pradeepsk13/vsdsram_sky130_1.8V/others/holdsnm1.jpg

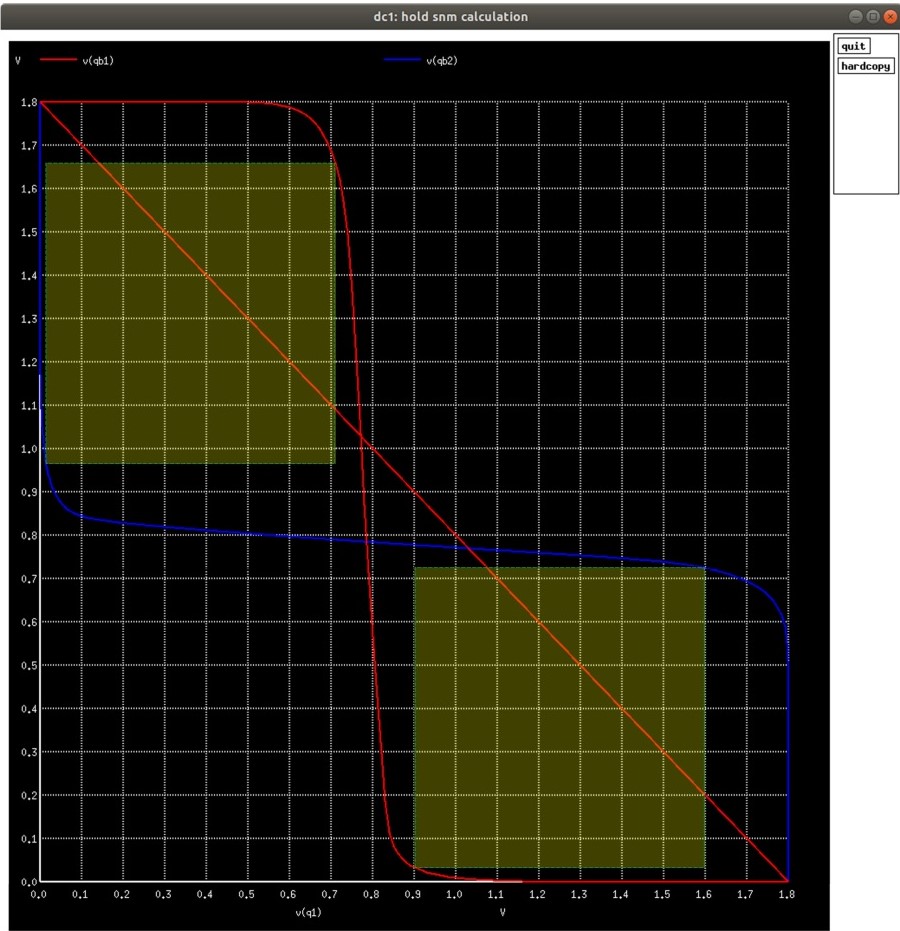
others/holdsnm1.jpg
