pradeepsk13/vsdsram_sky130_1.8V/others/layout_snaps/precharge_circuit.png

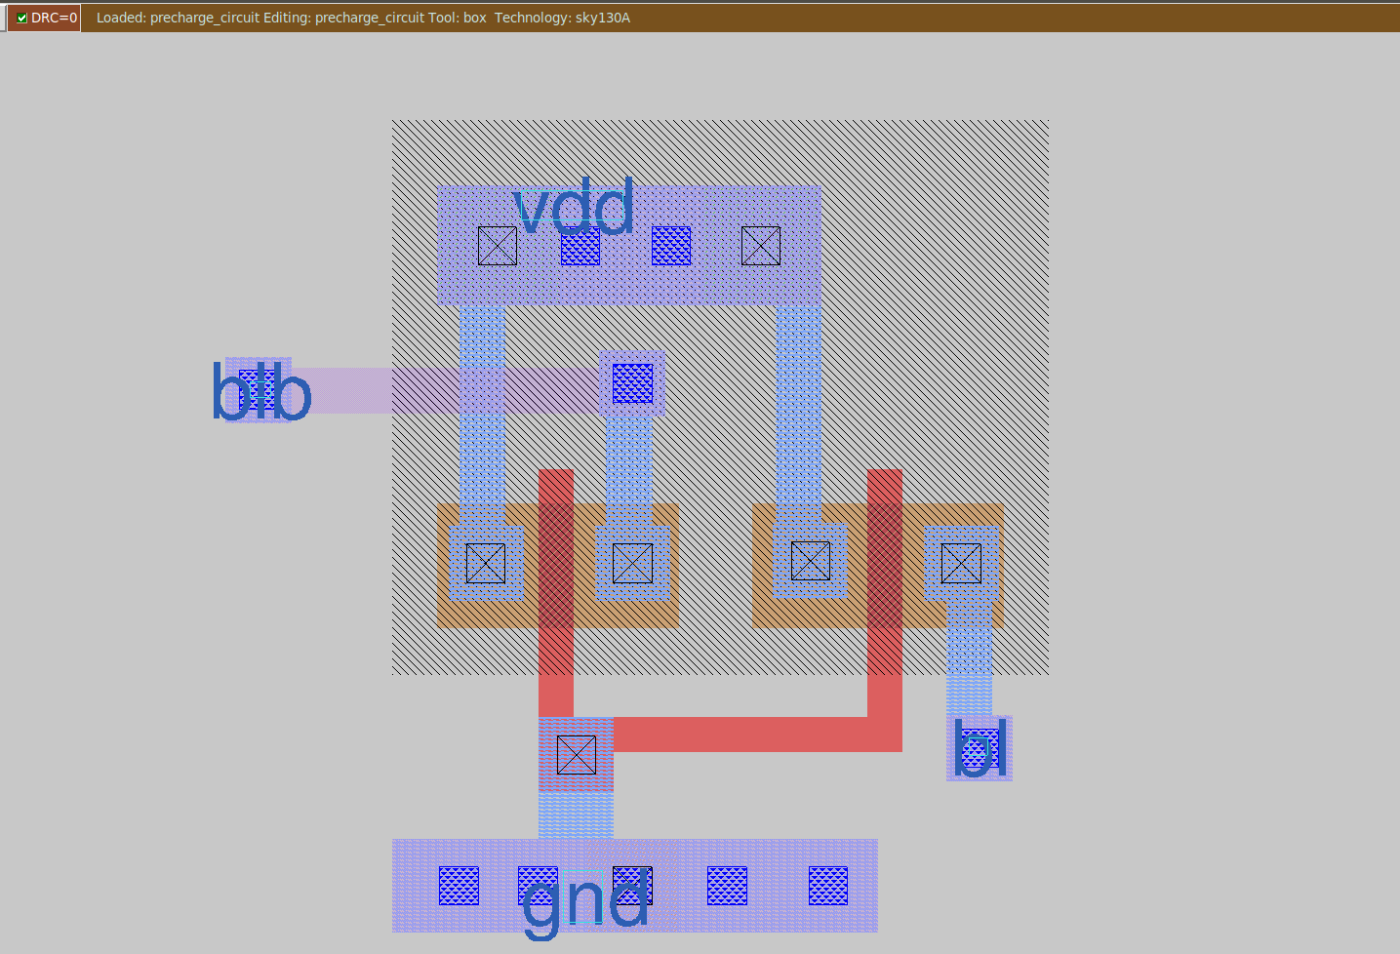
others/layout_snaps/precharge_circuit.png
