pradeepsk13/vsdsram_sky130_1.8V/others/readsnm1.png

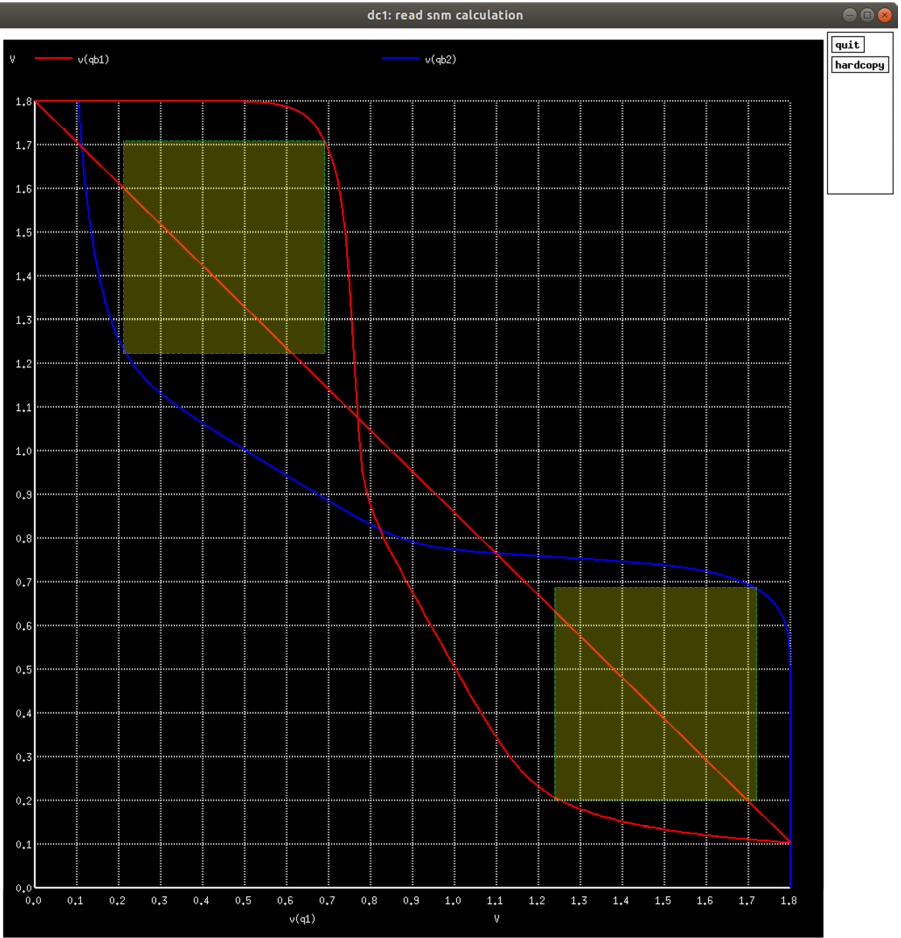
others/readsnm1.png
