pradeepsk13/vsdsram_sky130_1.8V/others/writesnm1.png

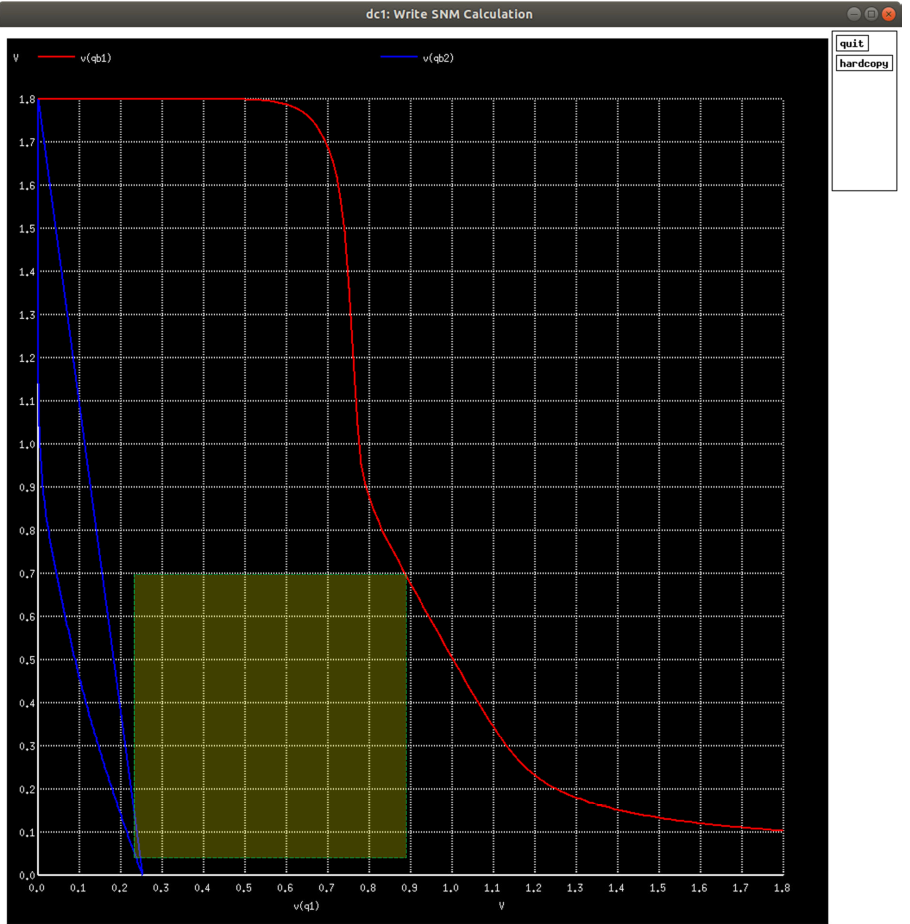
others/writesnm1.png
