pradeepsk13/vsdsram_sky130_1.8V/waveforms/prelayout/ncurve_read.png

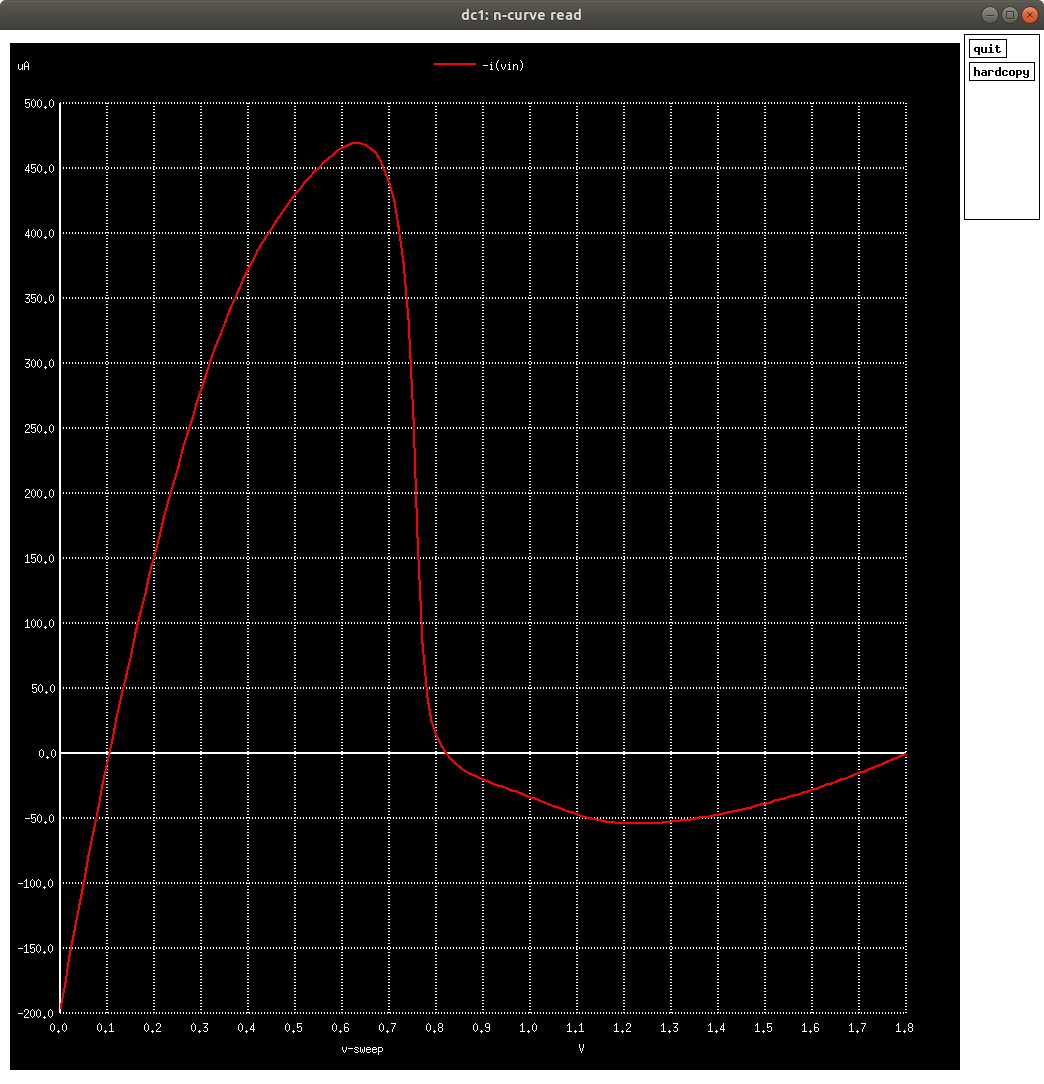
waveforms/prelayout/ncurve_read.png
