pradeepsk13/vsdsram_sky130_1.8V/Openram/Openram_Results/31_03_21_VSDSRAM_2x16/sram_2_16_sky130A.html

VLSIDA

(https://vlsida.soe.ucsc.edu/) (https://github.com/VLSIDA/OpenRAM)

OpenRAM

sram_2_16_sky130A.html

Compiled at: 2021-03-30

DRC errors: skipped

LVS errors: skipped

Git commit id: 608e4b81f1763727e7efe087d591c76956869fe6

Ports and Configuration

Type | Value
WORD_SIZE | 2
NUM_WORDS | 16
NUM_BANKS | 1
NUM_RW_PORTS | 1
NUM_R_PORTS | 0
NUM_W_PORTS | 0
Area (µm²) | 7121

Operating Conditions

Parameter | Min | Typ | Max | Units
Power supply (VDD) range | 1.8 | 1.8 | 1.8 | Volts
Operating Temperature | 0 | 25 | 100 | Celsius
Operating Frequency (F) | | | 174 | MHz

Timing Data

Using analytical model: results may not be precise

Parameter | Min | Max | Units
din0[1:0] setup rising | 0.009 | 0.009 | ns
din0[1:0] setup falling | 0.009 | 0.009 | ns
din0[1:0] hold rising | 0.001 | 0.001 | ns
din0[1:0] hold falling | 0.001 | 0.001 | ns
dout0[1:0] cell rise | -0.975 | 1.702 | ns
dout0[1:0] cell fall | 1.344 | 1.547 | ns
dout0[1:0] rise transition | 0.007 | 0.027 | ns
dout0[1:0] fall transition | 0.007 | 0.027 | ns
csb0 setup rising | 0.009 | 0.009 | ns
csb0 setup falling | 0.009 | 0.009 | ns
csb0 hold rising | 0.001 | 0.001 | ns
csb0 hold falling | 0.001 | 0.001 | ns
addr0[3:0] setup rising | 0.009 | 0.009 | ns
addr0[3:0] setup falling | 0.009 | 0.009 | ns
addr0[3:0] hold rising | 0.001 | 0.001 | ns
addr0[3:0] hold falling | 0.001 | 0.001 | ns
web0 setup rising | 0.009 | 0.009 | ns
web0 setup falling | 0.009 | 0.009 | ns
web0 hold rising | 0.001 | 0.001 | ns
web0 hold falling | 0.001 | 0.001 | ns

Power Data

Pins | Mode | Power | Units
!csb0 & clk0 & !web0 | Read Rising | 0.4618 | mW
!csb0 & clk0 & !web0 | Read Falling | 0.4618 | mW
!csb0 & !clk0 & web0 | Write Rising | 0.4618 | mW
!csb0 & !clk0 & web0 | Write Falling | 0.4618 | mW
csb0 | leakage | 0.000196 | mW

Characterization Corners

Transistor Type | Power Supply | Temperature | Corner Name
TT | 1.8 | 25 | _TT_1p8V_25C.lib
SS | 1.8 | 25 | _SS_1p8V_25C.lib
FF | 1.8 | 25 | _FF_1p8V_25C.lib
TT | 1.8 | 100 | _TT_1p8V_100C.lib
TT | 1.8 | 0 | _TT_1p8V_0C.lib

Deliverables

Type | Description | Link
.gds | GDSII layout views | sram_2_16_sky130A.gds
.html | This datasheet | sram_2_16_sky130A.html
.lef | LEF files | sram_2_16_sky130A.lef
.lib | Synthesis models | sram_2_16_sky130A_TT_1p8V_25C.lib
.lib | Synthesis models | sram_2_16_sky130A_SS_1p8V_25C.lib
.lib | Synthesis models | sram_2_16_sky130A_FF_1p8V_25C.lib
.lib | Synthesis models | sram_2_16_sky130A_TT_1p8V_100C.lib
.lib | Synthesis models | sram_2_16_sky130A_TT_1p8V_0C.lib
.log | OpenRAM compile log | sram_2_16_sky130A.log
.py | OpenRAM configuration file | sram_2_16_sky130A.py
.sp | SPICE netlists | sram_2_16_sky130A.sp
.v | Verilog simulation models | sram_2_16_sky130A.v
