pradeepsk13/vsdsram_sky130_1.8V/Openram/Openram_Results/31_03_21_VSDSRAM_2x16/functional_stim.sp

* Functional test stimulus file for 20ns period

* TT process corner
.include "/home/peepu/VSDSRAM_sky130/OpenRAM/technology/sky130A/models/corners/tt.sp"
.include "sram_2_16_sky130A.sp"

* Global Power Supplies
Vvdd vdd 0 1.8

*Nodes gnd and 0 are the same global ground node in ngspice/hspice/xa. Otherwise, this source may be needed.
*Vgnd gnd 0 0.0

* Instantiation of the SRAM
Xsram_2_16_sky130A din0_0 din0_1 a0_0 a0_1 a0_2 a0_3 CSB0 WEB0 clk0 dout0_0 dout0_1 vdd gnd sram_2_16_sky130A

* SRAM output loads
CD00 dout0_0  0 39.2968f
CD01 dout0_1  0 39.2968f


* Important signals for debug
* bl: xsram_2_16_sky130a.xbank0.bl_0_0
* br: xsram_2_16_sky130a.xbank0.br_0_0
* s_en: xsram_2_16_sky130a.s_en
* q: xsram_2_16_sky130A.xbank0.xbitcell_array.xbitcell_array.xbit_r0_c0.Q
* qbar: xsram_2_16_sky130A.xbank0.xbitcell_array.xbitcell_array.xbit_r0_c0.Q_bar


* Sequence of operations
*	Idle during cycle 0 (0ns - 20ns)
*	Writing 11  to  address 0001 (from port 0) during cycle 1 (20ns - 40ns)
*	Reading 11 from address 0001 (from port 0) during cycle 4 (80ns - 100ns)
*	Writing 10  to  address 0100 (from port 0) during cycle 5 (100ns - 120ns)
*	Writing 01  to  address 1001 (from port 0) during cycle 6 (120ns - 140ns)
*	Reading 11 from address 0001 (from port 0) during cycle 8 (160ns - 180ns)
*	Writing 01  to  address 0101 (from port 0) during cycle 9 (180ns - 200ns)
*	Reading 01 from address 1001 (from port 0) during cycle 11 (220ns - 240ns)
*	Reading 10 from address 0100 (from port 0) during cycle 12 (240ns - 260ns)
*	Writing 10  to  address 1001 (from port 0) during cycle 16 (320ns - 340ns)
*	Writing 11  to  address 0011 (from port 0) during cycle 17 (340ns - 360ns)
*	Reading 11 from address 0011 (from port 0) during cycle 19 (380ns - 400ns)
*	Writing 11  to  address 1010 (from port 0) during cycle 20 (400ns - 420ns)
*	Writing 01  to  address 1001 (from port 0) during cycle 21 (420ns - 440ns)
*	Writing 10  to  address 1010 (from port 0) during cycle 23 (460ns - 480ns)
*	Writing 01  to  address 0000 (from port 0) during cycle 24 (480ns - 500ns)
*	Writing 01  to  address 0110 (from port 0) during cycle 25 (500ns - 520ns)
*	Writing 10  to  address 1100 (from port 0) during cycle 26 (520ns - 540ns)
*	Reading 01 from address 0101 (from port 0) during cycle 27 (540ns - 560ns)
*	Writing 10  to  address 1011 (from port 0) during cycle 30 (600ns - 620ns)
*	Writing 00  to  address 1011 (from port 0) during cycle 33 (660ns - 680ns)
*	Reading 11 from address 0001 (from port 0) during cycle 34 (680ns - 700ns)
*	Reading 10 from address 1100 (from port 0) during cycle 35 (700ns - 720ns)
*	Reading 10 from address 0100 (from port 0) during cycle 37 (740ns - 760ns)
*	Writing 10  to  address 1111 (from port 0) during cycle 38 (760ns - 780ns)
*	Writing 10  to  address 1000 (from port 0) during cycle 40 (800ns - 820ns)
*	Writing 11  to  address 1100 (from port 0) during cycle 41 (820ns - 840ns)
*	Writing 01  to  address 0111 (from port 0) during cycle 42 (840ns - 860ns)
*	Reading 01 from address 1001 (from port 0) during cycle 43 (860ns - 880ns)
*	Reading 10 from address 1010 (from port 0) during cycle 44 (880ns - 900ns)
*	Writing 01  to  address 1100 (from port 0) during cycle 49 (980ns - 1000ns)
*	Reading 01 from address 0111 (from port 0) during cycle 50 (1000ns - 1020ns)
*	Writing 01  to  address 1110 (from port 0) during cycle 51 (1020ns - 1040ns)
*	Reading 01 from address 0000 (from port 0) during cycle 53 (1060ns - 1080ns)
*	Writing 11  to  address 1100 (from port 0) during cycle 54 (1080ns - 1100ns)
*	Reading 01 from address 1110 (from port 0) during cycle 55 (1100ns - 1120ns)
*	Reading 11 from address 0001 (from port 0) during cycle 56 (1120ns - 1140ns)
*	Writing 10  to  address 1101 (from port 0) during cycle 59 (1180ns - 1200ns)
*	Reading 01 from address 0111 (from port 0) during cycle 61 (1220ns - 1240ns)
*	Writing 01  to  address 1001 (from port 0) during cycle 63 (1260ns - 1280ns)
*	Reading 10 from address 1111 (from port 0) during cycle 64 (1280ns - 1300ns)
*	Writing 01  to  address 0010 (from port 0) during cycle 65 (1300ns - 1320ns)
*	Reading 11 from address 0001 (from port 0) during cycle 66 (1320ns - 1340ns)
*	Writing 10  to  address 1111 (from port 0) during cycle 67 (1340ns - 1360ns)
*	Reading 11 from address 0001 (from port 0) during cycle 69 (1380ns - 1400ns)
*	Reading 11 from address 0011 (from port 0) during cycle 70 (1400ns - 1420ns)
*	Writing 11  to  address 1011 (from port 0) during cycle 71 (1420ns - 1440ns)
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
