pradeepsk13/vsdsram_sky130_1.8V/Openram/Openram_Results/26_03_21_VSDSRAM_32x256/functional_stim.sp

* Functional test stimulus file for 20ns period

* TT process corner
.include "/home/peepu/VSDSRAM_sky130/OpenRAM/technology/sky130A/models/corners/tt.sp"
.include "sram_32_256_sky130A.sp"

* Global Power Supplies
Vvdd vdd 0 1.8

*Nodes gnd and 0 are the same global ground node in ngspice/hspice/xa. Otherwise, this source may be needed.
*Vgnd gnd 0 0.0

* Instantiation of the SRAM
Xsram_32_256_sky130A din0_0 din0_1 din0_2 din0_3 din0_4 din0_5 din0_6 din0_7 din0_8 din0_9 din0_10 din0_11 din0_12 din0_13 din0_14 din0_15 din0_16 din0_17 din0_18 din0_19 din0_20 din0_21 din0_22 din0_23 din0_24 din0_25 din0_26 din0_27 din0_28 din0_29 din0_30 din0_31 a0_0 a0_1 a0_2 a0_3 a0_4 a0_5 a0_6 a0_7 CSB0 WEB0 clk0 dout0_0 dout0_1 dout0_2 dout0_3 dout0_4 dout0_5 dout0_6 dout0_7 dout0_8 dout0_9 dout0_10 dout0_11 dout0_12 dout0_13 dout0_14 dout0_15 dout0_16 dout0_17 dout0_18 dout0_19 dout0_20 dout0_21 dout0_22 dout0_23 dout0_24 dout0_25 dout0_26 dout0_27 dout0_28 dout0_29 dout0_30 dout0_31 vdd gnd sram_32_256_sky130A

* SRAM output loads
CD00 dout0_0  0 39.2968f
CD01 dout0_1  0 39.2968f
CD02 dout0_2  0 39.2968f
CD03 dout0_3  0 39.2968f
CD04 dout0_4  0 39.2968f
CD05 dout0_5  0 39.2968f
CD06 dout0_6  0 39.2968f
CD07 dout0_7  0 39.2968f
CD08 dout0_8  0 39.2968f
CD09 dout0_9  0 39.2968f
CD010 dout0_10  0 39.2968f
CD011 dout0_11  0 39.2968f
CD012 dout0_12  0 39.2968f
CD013 dout0_13  0 39.2968f
CD014 dout0_14  0 39.2968f
CD015 dout0_15  0 39.2968f
CD016 dout0_16  0 39.2968f
CD017 dout0_17  0 39.2968f
CD018 dout0_18  0 39.2968f
CD019 dout0_19  0 39.2968f
CD020 dout0_20  0 39.2968f
CD021 dout0_21  0 39.2968f
CD022 dout0_22  0 39.2968f
CD023 dout0_23  0 39.2968f
CD024 dout0_24  0 39.2968f
CD025 dout0_25  0 39.2968f
CD026 dout0_26  0 39.2968f
CD027 dout0_27  0 39.2968f
CD028 dout0_28  0 39.2968f
CD029 dout0_29  0 39.2968f
CD030 dout0_30  0 39.2968f
CD031 dout0_31  0 39.2968f


* Important signals for debug
* bl: xsram_32_256_sky130a.xbank0.bl_0_0
* br: xsram_32_256_sky130a.xbank0.br_0_0
* s_en: xsram_32_256_sky130a.s_en
* q: xsram_32_256_sky130A.xbank0.xbitcell_array.xbitcell_array.xbit_r0_c0.Q
* qbar: xsram_32_256_sky130A.xbank0.xbitcell_array.xbitcell_array.xbit_r0_c0.Q_bar


* Sequence of operations
*	Idle during cycle 0 (0ns - 20ns)
*	Writing 11110110010100110001001101101100  to  address 01100000 (from port 0) during cycle 1 (20ns - 40ns)
*	Reading 11110110010100110001001101101100 from address 01100000 (from port 0) during cycle 3 (60ns - 80ns)
*	Writing 11111010001010111110010110100101  to  address 01100111 (from port 0) during cycle 5 (100ns - 120ns)
*	Reading 11110110010100110001001101101100 from address 01100000 (from port 0) during cycle 6 (120ns - 140ns)
*	Writing 00000111110101111101101011111010  to  address 11110000 (from port 0) during cycle 8 (160ns - 180ns)
*	Reading 00000111110101111101101011111010 from address 11110000 (from port 0) during cycle 9 (180ns - 200ns)
*	Writing 01100100100101001000010001101101  to  address 00010101 (from port 0) during cycle 10 (200ns - 220ns)
*	Reading 11111010001010111110010110100101 from address 01100111 (from port 0) during cycle 11 (220ns - 240ns)
*	Writing 10101100100001011000111101110000  to  address 11101000 (from port 0) during cycle 13 (260ns - 280ns)
*	Reading 10101100100001011000111101110000 from address 11101000 (from port 0) during cycle 14 (280ns - 300ns)
*	Reading 00000111110101111101101011111010 from address 11110000 (from port 0) during cycle 15 (300ns - 320ns)
*	Reading 10101100100001011000111101110000 from address 11101000 (from port 0) during cycle 16 (320ns - 340ns)
*	Writing 00011111111010100000000100011100  to  address 11110000 (from port 0) during cycle 17 (340ns - 360ns)
*	Writing 01011100001111000011011011100101  to  address 10011101 (from port 0) during cycle 18 (360ns - 380ns)
*	Reading 11111010001010111110010110100101 from address 01100111 (from port 0) during cycle 19 (380ns - 400ns)
*	Reading 01011100001111000011011011100101 from address 10011101 (from port 0) during cycle 20 (400ns - 420ns)
*	Writing 00001000010101111011110000010101  to  address 11110011 (from port 0) during cycle 21 (420ns - 440ns)
*	Writing 10001100010000111101111010001100  to  address 01110110 (from port 0) during cycle 22 (440ns - 460ns)
*	Writing 10100010010110000011011011011110  to  address 01110011 (from port 0) during cycle 23 (460ns - 480ns)
*	Reading 01011100001111000011011011100101 from address 10011101 (from port 0) during cycle 24 (480ns - 500ns)
*	Reading 10100010010110000011011011011110 from address 01110011 (from port 0) during cycle 25 (500ns - 520ns)
*	Writing 11110001000001011000100000101010  to  address 01101100 (from port 0) during cycle 26 (520ns - 540ns)
*	Writing 10001101000001010110111110000001  to  address 00010010 (from port 0) during cycle 30 (600ns - 620ns)
*	Reading 11110110010100110001001101101100 from address 01100000 (from port 0) during cycle 31 (620ns - 640ns)
*	Reading 01100100100101001000010001101101 from address 00010101 (from port 0) during cycle 32 (640ns - 660ns)
*	Reading 10001101000001010110111110000001 from address 00010010 (from port 0) during cycle 36 (720ns - 740ns)
*	Writing 10111010100000000100111100011110  to  address 10001100 (from port 0) during cycle 37 (740ns - 760ns)
*	Writing 10001001000001110001010100011000  to  address 11111110 (from port 0) during cycle 38 (760ns - 780ns)
*	Writing 01001000111100001010010110010101  to  address 11010000 (from port 0) during cycle 39 (780ns - 800ns)
*	Reading 10001101000001010110111110000001 from address 00010010 (from port 0) during cycle 40 (800ns - 820ns)
*	Reading 01100100100101001000010001101101 from address 00010101 (from port 0) during cycle 42 (840ns - 860ns)
*	Reading 10101100100001011000111101110000 from address 11101000 (from port 0) during cycle 43 (860ns - 880ns)
*	Writing 00111111111110010101101001010100  to  address 11110101 (from port 0) during cycle 44 (880ns - 900ns)
*	Writing 10100111100111100011101100000100  to  address 11001100 (from port 0) during cycle 45 (900ns - 920ns)
*	Writing 11011011011010101010100110000000  to  address 11011001 (from port 0) during cycle 46 (920ns - 940ns)
*	Writing 01110010000011001011101001001001  to  address 11010010 (from port 0) during cycle 47 (940ns - 960ns)
*	Writing 11010010110010100110000001111010  to  address 11010111 (from port 0) during cycle 48 (960ns - 980ns)
*	Writing 00111010001001101010101011000110  to  address 00001111 (from port 0) during cycle 49 (980ns - 1000ns)
*	Reading 01100100100101001000010001101101 from address 00010101 (from port 0) during cycle 50 (1000ns - 1020ns)
*	Writing 11101001011111110101001110010000  to  address 11000000 (from port 0) during cycle 51 (1020ns - 1040ns)
*	Writing 00001100000100011101100001111010  to  address 10010011 (from port 0) during cycle 52 (1040ns - 1060ns)
*	Reading 10001100010000111101111010001100 from address 01110110 (from port 0) during cycle 55 (1100ns - 1120ns)
*	Writing 00000111111111110010000100101001  to  address 01001001 (from port 0) during cycle 56 (1120ns - 1140ns)
*	Writing 01000001100010111101000010000010  to  address 00001011 (from port 0) during cycle 58 (1160ns - 1180ns)
*	Writing 01001111001110110010111111011011  to  address 10010010 (from port 0) during cycle 59 (1180ns - 1200ns)
*	Reading 10100111100111100011101100000100 from address 11001100 (from port 0) during cycle 61 (1220ns - 1240ns)
*	Reading 10100010010110000011011011011110 from address 01110011 (from port 0) during cycle 62 (1240ns - 1260ns)
*	Reading 11101001011111110101001110010000 from address 11000000 (from port 0) during cycle 64 (1280ns - 1300ns)
*	Writing 01100110011000101001000011011011  to  address 11011110 (from port 0) during cycle 67 (1340ns - 1360ns)
*	Writing 01100110111010101111110000000100  to  address 01011101 (from port 0) during cycle 68 (1360ns - 1380ns)
*	Reading 01001111001110110010111111011011 from address 10010010 (from port 0) during cycle 70 (1400ns - 1420ns)
*	Writing 11001001110111101001111110011101  to  address 11000000 (from port 0) during cycle 74 (1480ns - 1500ns)
*	Reading 11010010110010100110000001111010 from address 11010111 (from port 0) during cycle 75 (1500ns - 1520ns)
*	Reading 00111111111110010101101001010100 from address 11110101 (from port 0) during cycle 76 (1520ns - 1540ns)
*	Writing 11101010110010100101001010000000  to  address 01000011 (from port 0) during cycle 77 (1540ns - 1560ns)
*	Writing 00100000000101101010000110110010  to  address 00011000 (from port 0) during cycle 79 (1580ns - 1600ns)
*	Reading 11011011011010101010100110000000 from address 11011001 (from port 0) during cycle 82 (1640ns - 1660ns)
*	Writing 00111001010110010010010011111011  to  address 00011111 (from port 0) during cycle 83 (1660ns - 1680ns)
*	Writing 00001010110100011001111010010001  to  address 01010111 (from port 0) during cycle 85 (1700ns - 1720ns)
*	Writing 10010001010010001011110000001011  to  address 00000101 (from port 0) during cycle 86 (1720ns - 1740ns)
*	Writing 10000110010010101100000110100100  to  address 00111110 (from port 0) during cycle 87 (1740ns - 1760ns)
*	Writing 01111101011010010000001011111101  to  address 10000010 (from port 0) during cycle 88 (1760ns - 1780ns)
*	Reading 00100000000101101010000110110010 from address 00011000 (from port 0) during cycle 90 (1800ns - 1820ns)
*	Writing 11100111110100100011010001011110  to  address 01000000 (from port 0) during cycle 91 (1820ns - 1840ns)
*	Reading 00001100000100011101100001111010 from address 10010011 (from port 0) during cycle 94 (1880ns - 1900ns)
*	Writing 10110011101111110111111101010001  to  address 01110101 (from port 0) during cycle 95 (1900ns - 1920ns)
*	Reading 00111010001001101010101011000110 from address 00001111 (from port 0) during cycle 96 (1920ns - 1940ns)
*	Writing 10100101110011011101000011101010  to  address 10101010 (from port 0) during cycle 97 (1940ns - 1960ns)
*	Writing 10111000111110111001101010111101  to  address 01010100 (from port 0) during cycle 99 (1980ns - 2000ns)
*	Writing 01100110001010111110001011010110  to  address 01010000 (from port 0) during cycle 100 (2000ns - 2020ns)
*	Reading 10100010010110000011011011011110 from address 01110011 (from port 0) during cycle 101 (2020ns - 2040ns)
*	Reading 10001101000001010110111110000001 from address 00010010 (from port 0) during cycle 102 (2040ns - 2060ns)
*	Writing 11101011111100001001011101000111  to  address 11101000 (from port 0) during cycle 103 (2060ns - 2080ns)
*	Reading 10000110010010101100000110100100 from address 00111110 (from port 0) during cycle 104 (2080ns - 2100ns)
*	Writing 10111100000100000011001011110110  to  address 00101110 (from port 0) during cycle 105 (2100ns - 2120ns)
*	Reading 01110010000011001011101001001001 from address 11010010 (from port 0) during cycle 106 (2120ns - 2140ns)
*	Writing 10101110100011110111111001001110  to  address 01001000 (from port 0) during cycle 107 (2140ns - 2160ns)
*	Writing 00000011000010110010011110010101  to  address 00110010 (from port 0) during cycle 108 (2160ns - 2180ns)
*	Writing 10011001100001111011000101111110  to  address 11100100 (from port 0) during cycle 109 (2180ns - 2200ns)
*	Writing 11100010000000010010001101011000  to  address 10001001 (from port 0) during cycle 110 (2200ns - 2220ns)
*	Reading 01001000111100001010010110010101 from address 11010000 (from port 0) during cycle 111 (2220ns - 2240ns)
*	Reading 10100111100111100011101100000100 from address 11001100 (from port 0) during cycle 112 (2240ns - 2260ns)
*	Reading 10111000111110111001101010111101 from address 01010100 (from port 0) during cycle 113 (2260ns - 2280ns)
*	Reading 10011001100001111011000101111110 from address 11100100 (from port 0) during cycle 115 (2300ns - 2320ns)
*	Reading 10000110010010101100000110100100 from address 00111110 (from port 0) during cycle 116 (2320ns - 2340ns)
*	Reading 01000001100010111101000010000010 from address 00001011 (from port 0) during cycle 117 (2340ns - 2360ns)
*	Reading 10001100010000111101111010001100 from address 01110110 (from port 0) during cycle 118 (2360ns - 2380ns)
*	Writing 01011101110111011011010011100000  to  address 11111111 (from port 0) during cycle 119 (2380ns - 2400ns)
*	Reading 00001100000100011101100001111010 from address 10010011 (from port 0) during cycle 120 (2400ns - 2420ns)
*	Writing 10010000000100000100101101001001  to  address 01010110 (from port 0) during cycle 122 (2440ns - 2460ns)
*	Writing 01010010111100111101101000001110  to  address 10111111 (from port 0) during cycle 123 (2460ns - 2480ns)
*	Reading 01100110011000101001000011011011 from address 11011110 (from port 0) during cycle 124 (2480ns - 2500ns)
*	Writing 00011011001111000101101010001100  to  address 00010000 (from port 0) during cycle 125 (2500ns - 2520ns)
*	Writing 11001001101100101001110001101011  to  address 10000100 (from port 0) during cycle 126 (2520ns - 2540ns)
*	Writing 10100001110001010011000011011100  to  address 01110011 (from port 0) during cycle 127 (2540ns - 2560ns)
*	Reading 11001001110111101001111110011101 from address 11000000 (from port 0) during cycle 128 (2560ns - 2580ns)
*	Reading 01011100001111000011011011100101 from address 10011101 (from port 0) during cycle 129 (2580ns - 2600ns)
*	Writing 10110001001111111000111001000000  to  address 00011111 (from port 0) during cycle 130 (2600ns - 2620ns)
*	Writing 11001101110000001010110111001101  to  address 10011101 (from port 0) during cycle 131 (2620ns - 2640ns)
*	Reading 10010001010010001011110000001011 from address 00000101 (from port 0) during cycle 132 (2640ns - 2660ns)
*	Writing 00110011110010101001010000010100  to  address 00101101 (from port 0) during cycle 135 (2700ns - 2720ns)
*	Reading 11101010110010100101001010000000 from address 01000011 (from port 0) during cycle 136 (2720ns - 2740ns)
*	Reading 10110011101111110111111101010001 from address 01110101 (from port 0) during cycle 137 (2740ns - 2760ns)
*	Writing 10100110111000001010111000010101  to  address 10100011 (from port 0) during cycle 138 (2760ns - 2780ns)
*	Writing 00101100110011010111100100011111  to  address 01011101 (from port 0) during cycle 140 (2800ns - 2820ns)
*	Writing 11011111000110101000101100000101  to  address 10110001 (from port 0) during cycle 141 (2820ns - 2840ns)
*	Writing 01111101000100010111000100001010  to  address 00010101 (from port 0) during cycle 142 (2840ns - 2860ns)
*	Reading 10001101000001010110111110000001 from address 00010010 (from port 0) during cycle 143 (2860ns - 2880ns)
*	Reading 01100110001010111110001011010110 from address 01010000 (from port 0) during cycle 144 (2880ns - 2900ns)
*	Writing 00110110011111101011100101101001  to  address 10010110 (from port 0) during cycle 145 (2900ns - 2920ns)
*	Writing 01110101011110100011001001100000  to  address 11111000 (from port 0) during cycle 148 (2960ns - 2980ns)
*	Reading 01010010111100111101101000001110 from address 10111111 (from port 0) during cycle 151 (3020ns - 3040ns)
*	Writing 10101110111101111100011000110100  to  address 01101110 (from port 0) during cycle 152 (3040ns - 3060ns)
*	Writing 10000010101001000111010111001011  to  address 01111001 (from port 0) during cycle 153 (3060ns - 3080ns)
*	Reading 11011011011010101010100110000000 from address 11011001 (from port 0) during cycle 154 (3080ns - 3100ns)
*	Writing 01001101101011111010100011000100  to  address 11100011 (from port 0) during cycle 155 (3100ns - 3120ns)
*	Writing 01000101000101110100111010001011  to  address 11111100 (from port 0) during cycle 157 (3140ns - 3160ns)
*	Reading 01110010000011001011101001001001 from address 11010010 (from port 0) during cycle 159 (3180ns - 3200ns)
*	Reading 01100110001010111110001011010110 from address 01010000 (from port 0) during cycle 160 (3200ns - 3220ns)
*	Reading 11011111000110101000101100000101 from address 10110001 (from port 0) during cycle 162 (3240ns - 3260ns)
*	Reading 00011011001111000101101010001100 from address 00010000 (from port 0) during cycle 164 (3280ns - 3300ns)
*	Reading 00000111111111110010000100101001 from address 01001001 (from port 0) during cycle 165 (3300ns - 3320ns)
*	Writing 01010010110001010100100010100011  to  address 10011111 (from port 0) during cycle 166 (3320ns - 3340ns)
*	Reading 11001001101100101001110001101011 from address 10000100 (from port 0) during cycle 167 (3340ns - 3360ns)
*	Writing 11000110101101011101000011100101  to  address 10111010 (from port 0) during cycle 168 (3360ns - 3380ns)
*	Writing 00111100100111100110000101100101  to  address 01001100 (from port 0) during cycle 171 (3420ns - 3440ns)
*	Writing 01101100010000101110110110001100  to  address 00011001 (from port 0) during cycle 173 (3460ns - 3480ns)
*	Reading 11001001101100101001110001101011 from address 10000100 (from port 0) during cycle 174 (3480ns - 3500ns)
*	Writing 00001000001100001010000100111111  to  address 00011111 (from port 0) during cycle 175 (3500ns - 3520ns)
*	Writing 10010000100011110111100011101000  to  address 00111111 (from port 0) during cycle 176 (3520ns - 3540ns)
*	Writing 00001010111010100110011100111110  to  address 11001010 (from port 0) during cycle 178 (3560ns - 3580ns)
*	Writing 10111101011110011010101011000101  to  address 10110010 (from port 0) during cycle 180 (3600ns - 3620ns)
*	Reading 01001101101011111010100011000100 from address 11100011 (from port 0) during cycle 182 (3640ns - 3660ns)
*	Reading 10101110100011110111111001001110 from address 01001000 (from port 0) during cycle 184 (3680ns - 3700ns)
*	Writing 00000000101111011110101111011001  to  address 01100001 (from port 0) during cycle 185 (3700ns - 3720ns)
*	Writing 00000110011110101001010010111001  to  address 11101111 (from port 0) during cycle 188 (3760ns - 3780ns)
*	Writing 01100100010100010000011110111100  to  address 01000111 (from port 0) during cycle 189 (3780ns - 3800ns)
*	Reading 01100100010100010000011110111100 from address 01000111 (from port 0) during cycle 191 (3820ns - 3840ns)
*	Writing 10100010101110100101111001100001  to  address 10001000 (from port 0) during cycle 192 (3840ns - 3860ns)
*	Reading 01000001100010111101000010000010 from address 00001011 (from port 0) during cycle 194 (3880ns - 3900ns)
*	Writing 00001101000101011110010111000001  to  address 11000100 (from port 0) during cycle 195 (3900ns - 3920ns)
*	Writing 01100101000111010100001010000100  to  address 00111101 (from port 0) during cycle 196 (3920ns - 3940ns)
*	Writing 01110111111011111111100001011011  to  address 00010001 (from port 0) during cycle 197 (3940ns - 3960ns)
*	Reading 11100010000000010010001101011000 from address 10001001 (from port 0) during cycle 199 (3980ns - 4000ns)
*	Idle during cycle 203 (4060ns - 4080ns)
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
