pradeepsk13/vsdsram_sky130_1.8V/Layouts/1bitsram_ip_using_instance/precharge_circuit.spice

* NGSPICE file created from precharge_circuit.ext - technology: sky130A

.subckt precharge_circuit bl gnd vdd blb
X0 blb gnd vdd vdd sky130_fd_pr__pfet_01v8 w=550000u l=150000u
X1 bl gnd vdd vdd sky130_fd_pr__pfet_01v8 w=550000u l=150000u
C0 bl blb 0.01fF
C1 vdd bl 0.04fF
C2 vdd blb 0.46fF
.ends
