pradeepsk13/vsdsram_sky130_1.8V/Openram/Openram_Results/31_03_21_VSDSRAM_2x16/sram_2_16_sky130A_extended.py

accuracy_requirement = 0.75
analytical_delay = True
auto_delay_chain_sizing = False
bank_select = "bank_select"
bitcell = "bitcell_1port"
bitcell_array = "bitcell_array"
buf_dec = "pbuf"
check_lvsdrc = False
col_cap = "col_cap"
col_cap_array = "col_cap_array"
column_mux_array = "column_mux_array"
config_file = "/home/peepu/VSDSRAM_sky130/myconfig_sky130_2.py"
control_logic = "control_logic"
coverage = 0
debug = False
decoder = "hierarchical_decoder"
delay_chain = "delay_chain"
delay_chain_fanout_per_stage = 4
delay_chain_stages = 9
dff = "dff"
dff_array = "dff_array"
drc_exe = None
drc_name = ""
dummy_bitcell = "dummy_bitcell_1port"
inline_lvsdrc = False
inv_dec = "pinv"
is_unit_test = False
keep_temp = False
load_scales = [0.25, 1, 4]
local_array_size = 0
lvs_exe = None
lvs_name = ""
magic_exe = None
nand2_dec = "pnand2"
nand3_dec = "pnand3"
nand4_dec = "pnand4"
netlist_only = False
nominal_corner_only = False
num_banks = 1
num_r_ports = 0
num_rw_ports = 1
num_spare_cols = 0
num_spare_rows = 0
num_threads = 2
num_w_ports = 0
num_words = 16
openram_tech = "/home/peepu/VSDSRAM_sky130/OpenRAM/technology/sky130A/"
openram_temp = "/tmp/openram_peepu_13915_temp/"
output_extended_config = True
output_name = "sram_2_16_sky130A"
output_path = "/home/peepu/VSDSRAM_sky130/temp/"
overridden = {'__name__': True, '__doc__': True, '__package__': True, '__loader__': True, '__spec__': True, '__file__': True, '__cached__': True, '__builtins__': True, 'word_size': True, 'num_words': True, 'tech_name': True, 'process_corners': True, 'supply_voltages': True, 'output_path': True, 'output_name': True}
perimeter_pins = True
pex_exe = None
pex_name = ""
precharge_array = "precharge_array"
print_banner = True
process_corners = ['TT']
ptx = "ptx"
rbl_delay_percentage = 0.5
replica_bitcell = "replica_bitcell_1port"
replica_bitline = "replica_bitline"
route_supplies = "tree"
row_cap = "row_cap"
row_cap_array = "row_cap_array"
sense_amp = "sense_amp"
sense_amp_array = "sense_amp_array"
slew_scales = [0.25, 1, 8]
spice_exe = ""
spice_name = ""
supply_voltages = [1.8]
tech_name = "sky130A"
temperatures = [0, 25, 100]
tri_gate = "tri_gate"
tri_gate_array = "tri_gate_array"
trim_netlist = False
use_pex = False
verbose_level = 0
word_size = 2
wordline_driver = "wordline_driver"
words_per_row = 1
write_driver = "write_driver"
write_driver_array = "write_driver_array"
write_mask_and_array = "write_mask_and_array"
write_size = None
